amanotullah/DC-002/Hardware/Schematic-and-pcb/DC-002-3.csv

Total Holes: 119
Tool | Hole Size | Hole Shape | Plated | Quantity
T1 | 12.00Mil (0.305mm) | circle | PTH | 30
T2 | 13.00Mil (0.330mm) | circle | PTH | 20
T3 | 37.40Mil (0.950mm) | circle | PTH | 24
T4 | 39.02Mil (0.991mm) | circle | PTH | 3
T5 | 39.37Mil (1.000mm) | circle | PTH | 2
T6 | 45.28Mil (1.150mm) | circle | PTH | 32
T7 | 53.15Mil (1.350mm) | circle | PTH | 5
T8 | 55.12Mil (1.400mm) | circle | PTH | 1
T9 | 102.36Mil (2.600mm) | circle | PTH | 2
