amanotullah/DC-002/Documentation/DC-001/KY-040-debouncing/rotary-encoder.png

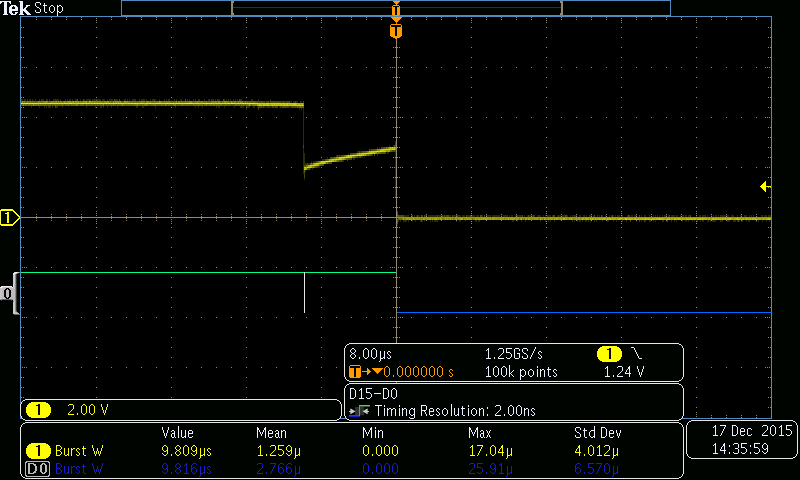
Documentation/DC-001/KY-040-debouncing/rotary-encoder.png
