amanotullah/DC-002/Documentation/DC-001/KY-040-debouncing/switch-bounce-2.png

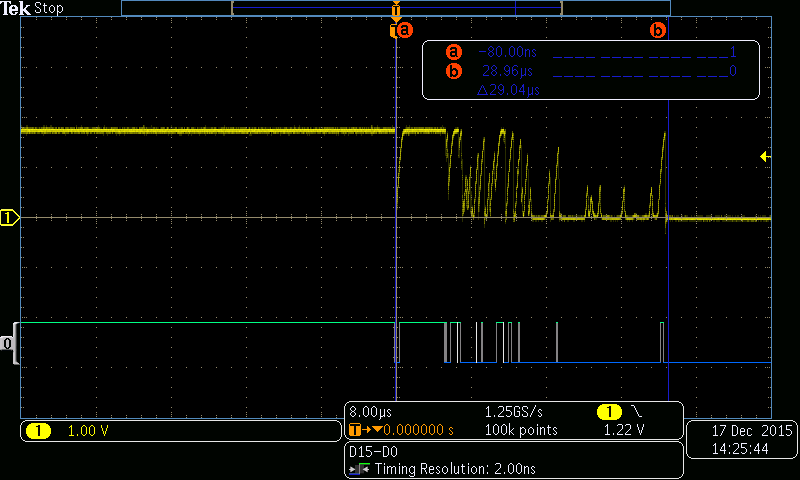
Documentation/DC-001/KY-040-debouncing/switch-bounce-2.png
