amanotullah/DC-002/Hardware/Schematic-and-pcb/DC-002.png

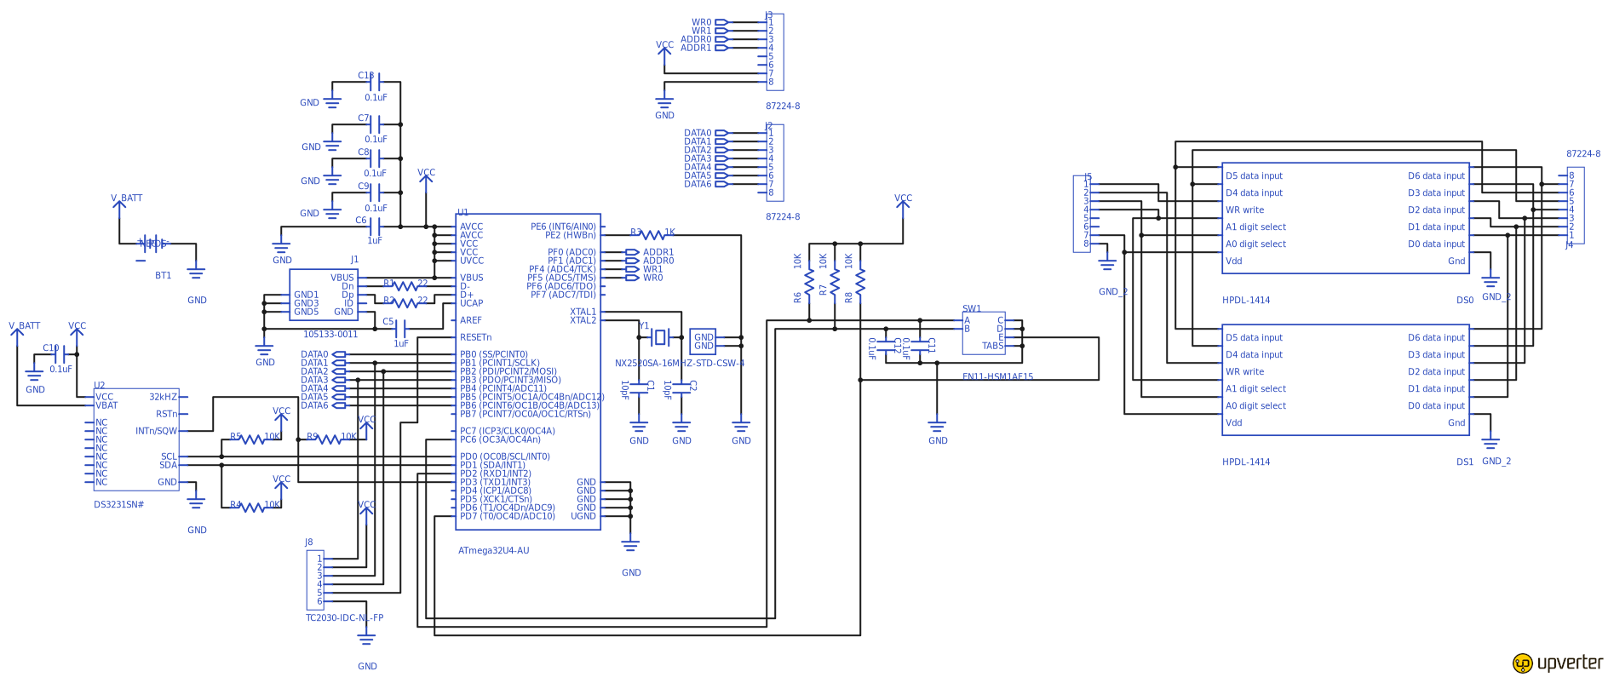
Hardware/Schematic-and-pcb/DC-002.png
