amanotullah/DC-002/Enclosure/DC-002-Case-1.2.stl

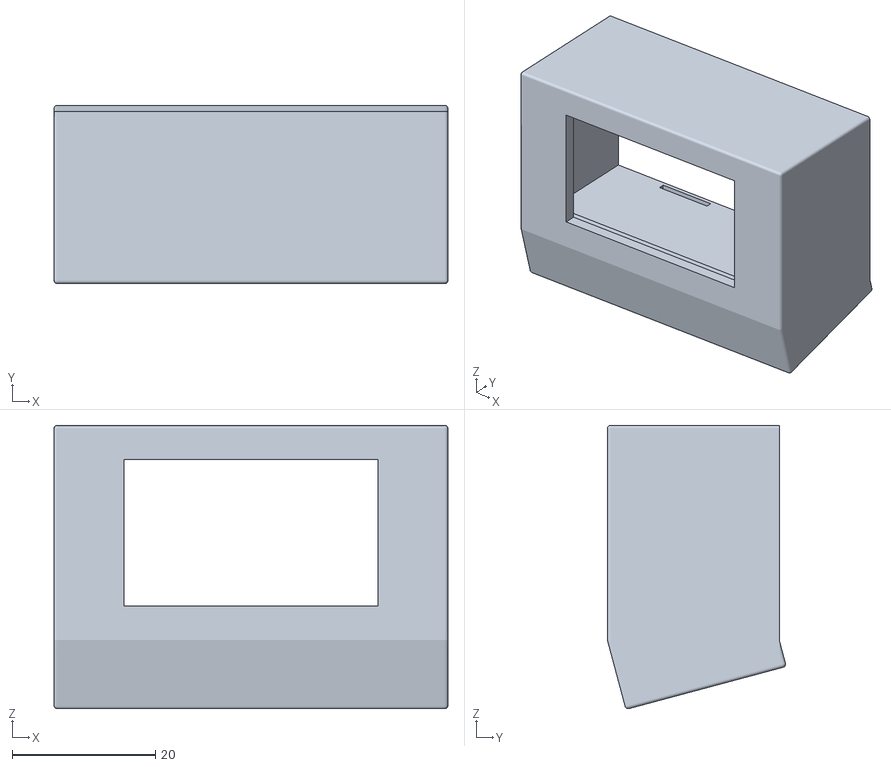
[picture p6: CAD file, 2016-12-21]
Enclosure/DC-002-Case-1.2.stl
55.0 x 24.9 x 39.6
