amanotullah/DC-002/Packaging/FoamOutlines/7-up-knobs.dxf

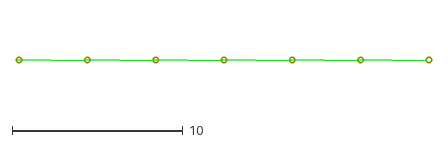
[picture p7: CAD file, 2016-12-21]
Packaging/FoamOutlines/7-up-knobs.dxf
24.3 x 0.315
