amanotullah/DC-002/Enclosure/DC-002-CaseBack-1.2.stl

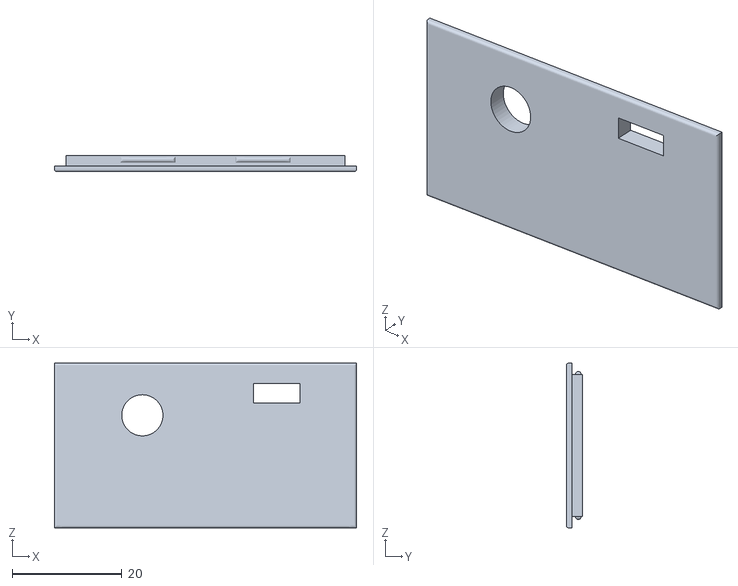
[picture p8: CAD file, 2016-12-21]
Enclosure/DC-002-CaseBack-1.2.stl
55.0 x 3.00 x 30.0
