amanotullah/DC-002/Packaging/FoamOutlines/2upclockAndSupply.dxf

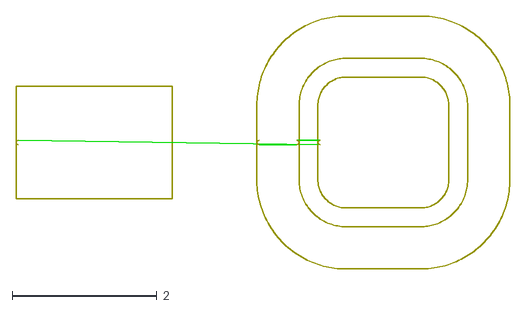
[picture p9: CAD file, 2016-12-21]
Packaging/FoamOutlines/2upclockAndSupply.dxf
6.83 x 3.50
