amanotullah/DC-002/Packaging/FoamOutlines/Knob.dxf

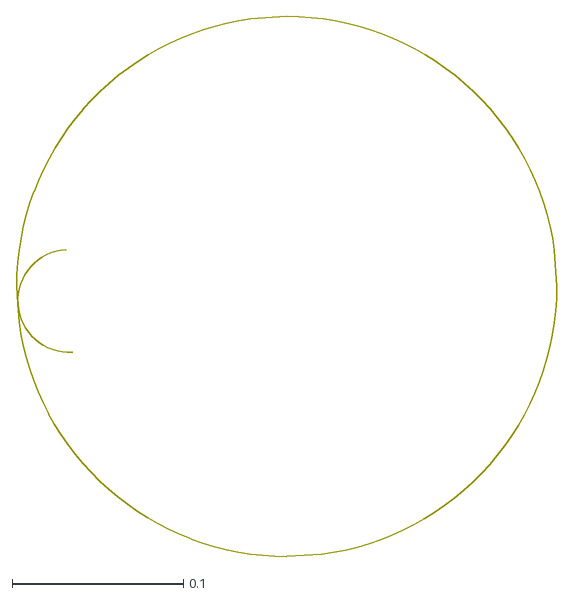
[picture p10: CAD file, 2016-12-21]
Packaging/FoamOutlines/Knob.dxf
0.315 x 0.315
