amanotullah/DC-002/Packaging/FoamOutlines/7-up-clocks.dxf

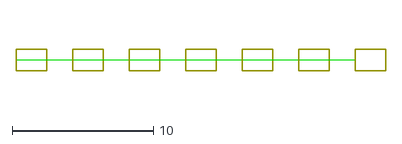
[picture p11: CAD file, 2016-12-21]
Packaging/FoamOutlines/7-up-clocks.dxf
26.2 x 1.56
