amanotullah/DC-002/Packaging/FoamOutlines/7-up-powersupply.dxf

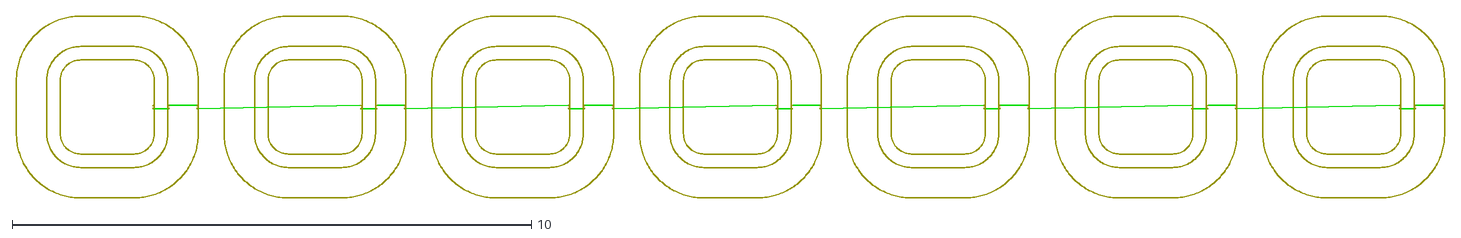
[picture p12: CAD file, 2016-12-21]
Packaging/FoamOutlines/7-up-powersupply.dxf
27.5 x 3.50
