amanotullah/DC-002/Hardware/Schematic-and-pcb/DC-002.pdf

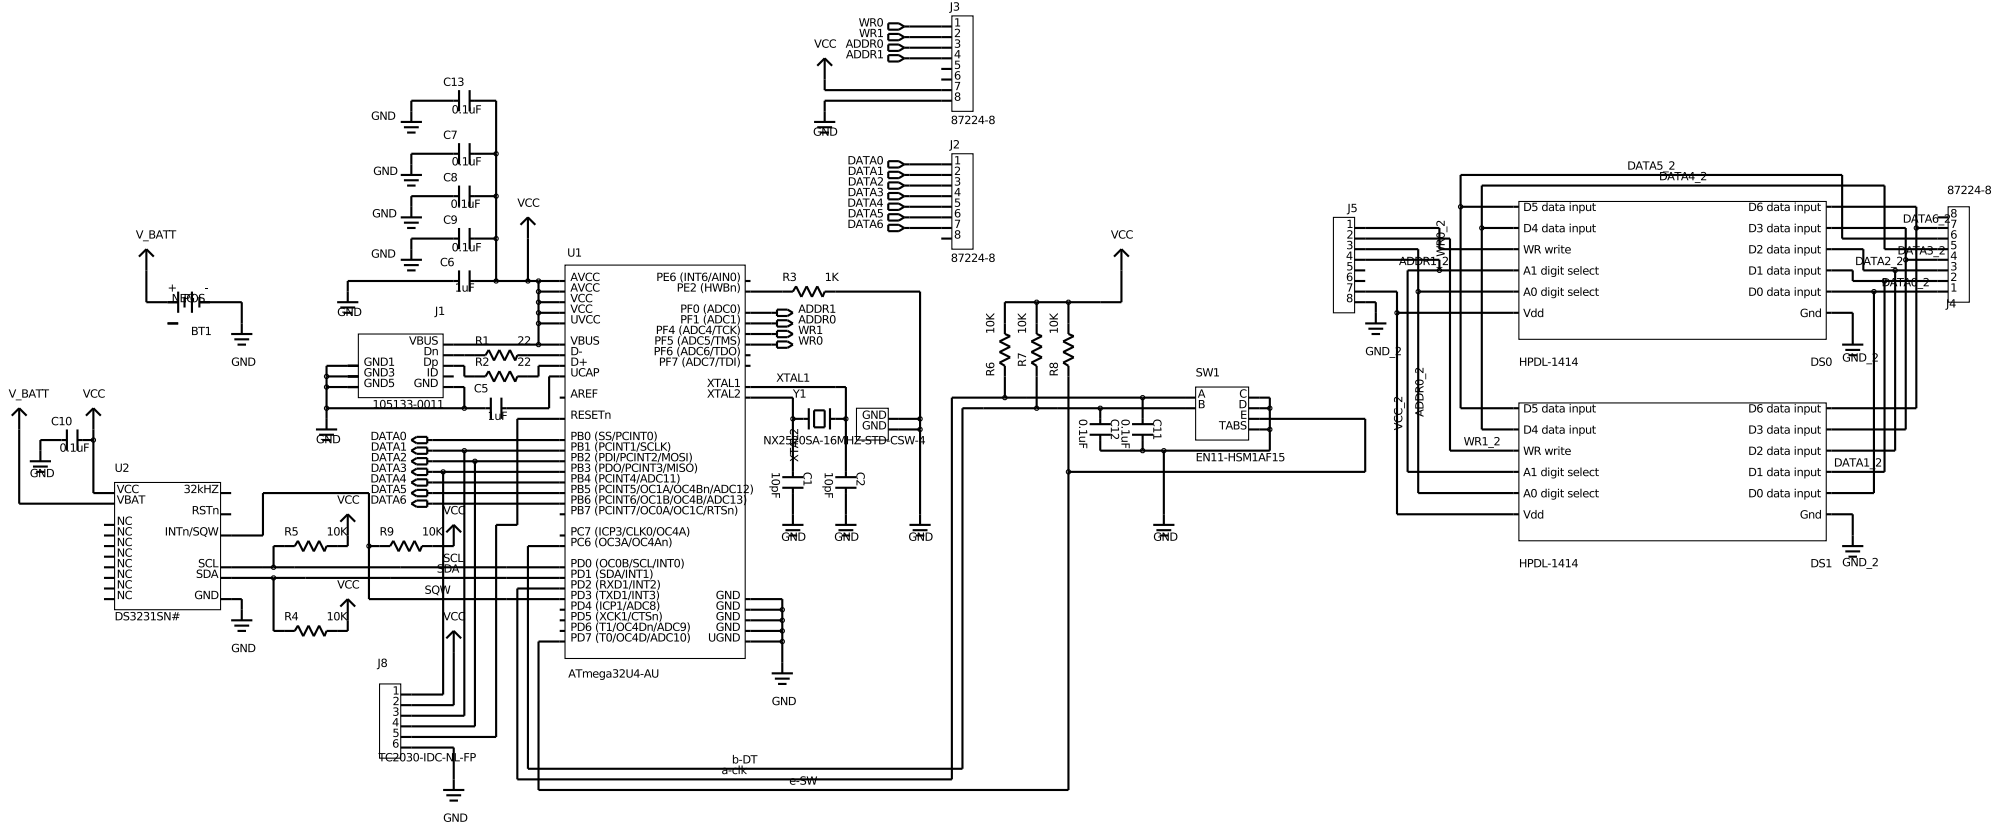
[picture p13: page 1]
