amanotullah/DC-002/(commit log)

2015-12-16 Menu Tweaks. Move menu to currently-selected option when drilling down. 24h time formatting improvements.
2015-12-16 Added date display. Added temperature placeholder display and F/C units.
2015-12-16 Added temperature display.
2015-12-21 Improve button debouncing.
2015-12-22 Adding error handling around pyserial import Trying to increase reliability by flushing and closing serial port.
    [setTime.py]
2015-12-23 Implement a new time syncing mechanism to lock CPU time to RTC time much more precisely. The new mechanism still tries to sync every 5 minutes, but when it is time to sync it looks at the current tim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
2016-12-21 Moved BOM and Pinouts to CSV files. Updated eratta.
    [DC-002-BOM.csv, DC-002-Pinouts.csv]
2016-12-21 Adding schematic and pcb designs
    [DC-002-2.csv, DC-002-3.csv, f3f2c238aae66400_14523070820000.csv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]
2016-12-21 Completing BOM including datasheet links and ref ids. Adding datasheets for all parts used.
    [DC-002-BOM.csv]
2016-12-21 Add missing resistors to BOM and fix typo
    [DC-002-BOM.csv]
2016-12-21 Renamed datasheets to find them more easily Added Tag-Connect to BOM for programming.
    [DC-002-BOM.csv]
2016-12-21 Updating schematic to 1.2 version submitted for manufacturing.
    [DC-002-2.csv, DC-002-3.csv, DC-002.csv, f3f2c238aae66400_14523070820000.csv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]
2016-12-21 Make pin adjustments for reworked DC-002 SN#005
    [DC-002.ino]
2016-12-21 Removed S/N 005 workaround after fixing fuses on S/N 005 unit.
    [DC-002.ino]
2016-12-21 Update User Manual for DC-002 Add Enclosure STL files
    [DC-002-Case-1.2.stl, DC-002-CaseBack-1.2.stl]
2016-12-21 Updated board gerbers and manual to fix silkscreen blurriness.
    [f3f2c238aae66400_14535061940000_gerbers.gto]
2016-12-21 Updating insert to have 4-up layout, reverse-page cutting guides for 4" cube box style packaging.
2016-12-21 Add temperature correction factor, write time to display immediately on boot.
    [DC-002.ino]
2016-12-21 Packaging outlines and CAM files.
    [2upclockAndSupply.dxf, 7-up-clocks.dxf, 7-up-knobs.dxf, 7-up-powersupply.dxf, Knob.dxf]
2017-02-07 Updated BOM to make it easy to order parts and added some additional notes.
    [DC-002-BOM.csv]
